physiker66/apple1_keyboard_controller/IMG_2471.JPG

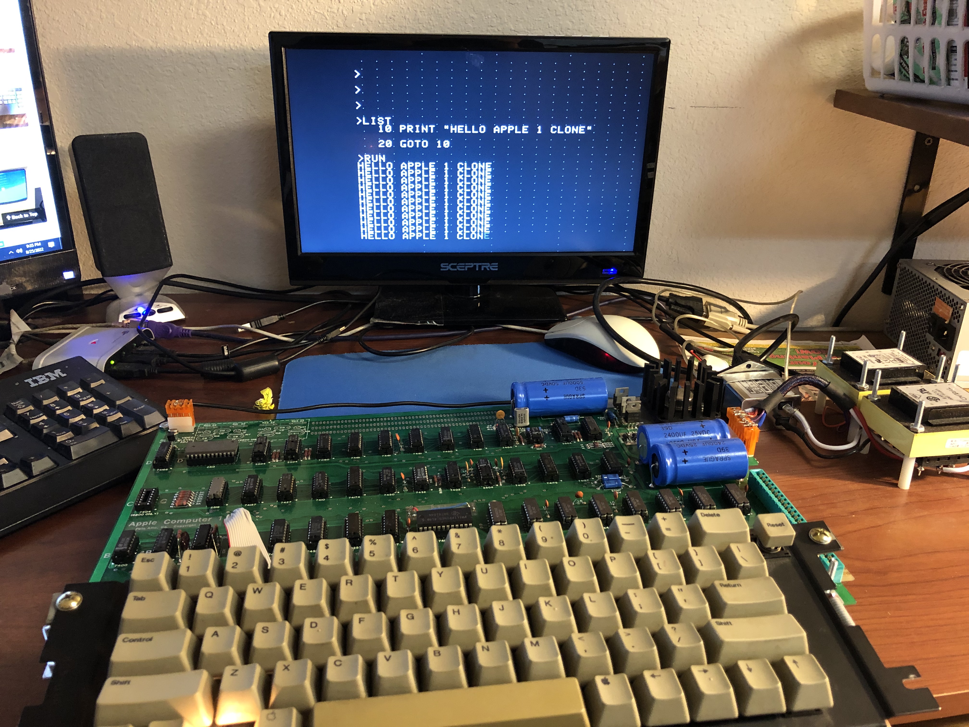
IMG_2471.JPG
