physiker66/apple1_keyboard_controller/schematic_v02.pdf

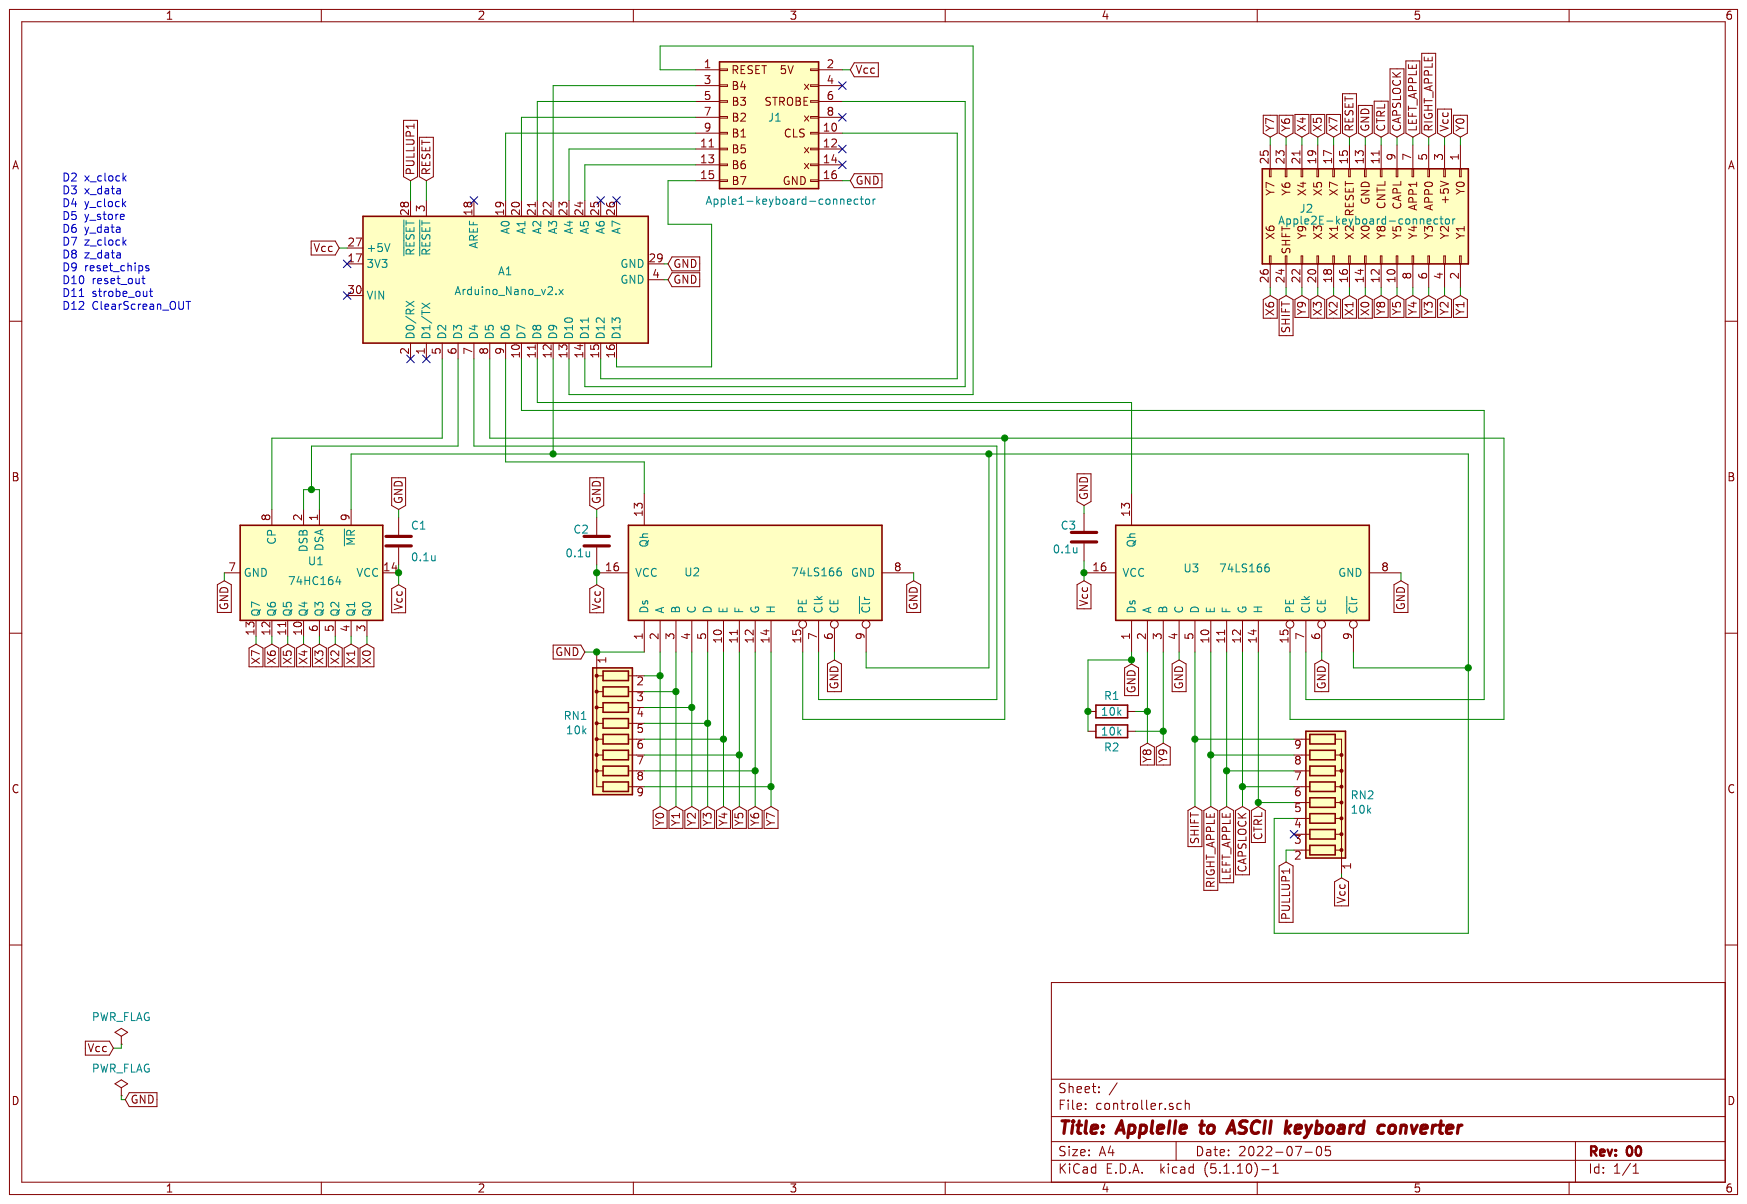
[picture p2: page 1]
